S-Dutta1/AutoM8A/foosball_cam.jpg

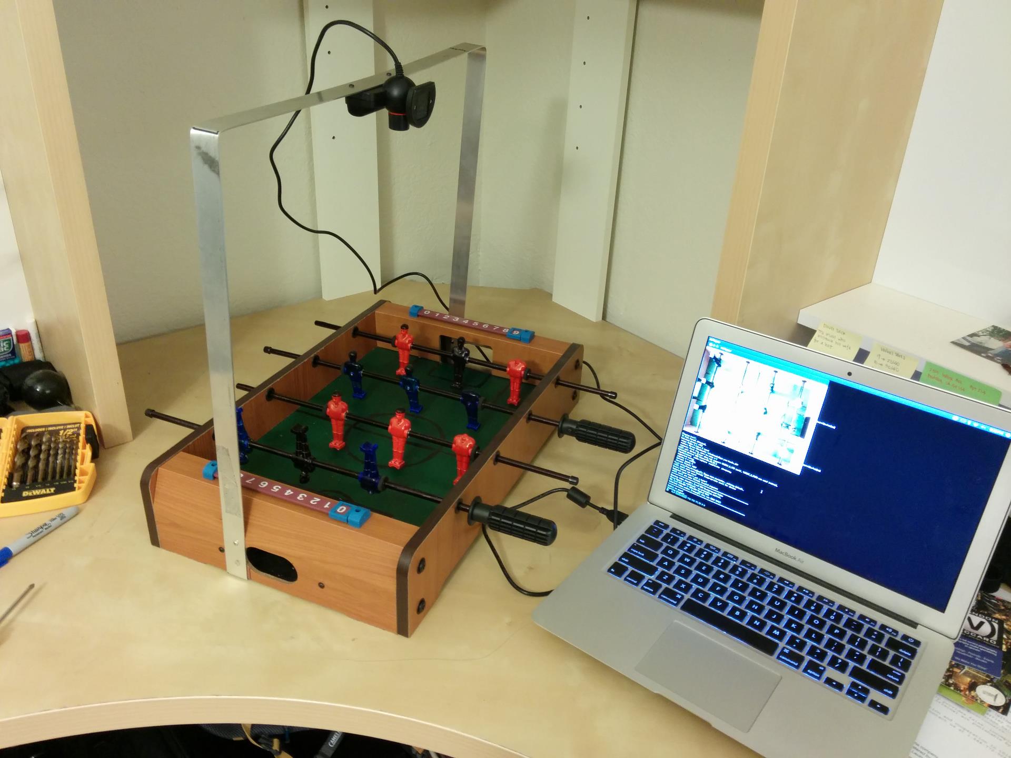
foosball_cam.jpg
