S-Dutta1/AutoM8A/README.md

# AutoM8A
ITSP (autonomous foosball table)

__Team details__ :  
1. Arkya Chatterjee  
2. Srijit Dutta  
3. Raunaque Patra   
4. Arunavo Mondal
  
*Mentor*: Abhin Shah
