S-Dutta1/AutoM8A/Billing info.ods

Component | Price | Qty | Delivery charges/tax | Total |  | Budget Expenditure
IR LED+Sensor |  |  |  | 1700 |  | 1700
LM339 comparator | 13 | 6 | 50 | 128 |  | 128
digital demux |  |  |  | 0 |  | 90
CD4067 analog mux |  |  |  | 0
V3006 servo | 400 | 4 |  | 1600 |  | 1600
Nema 17 stepper | 750 | 4 | 165 | 3165 |  | 3165
DRV8825 motor driver |  |  |  | 0 |  | 880
3D printer pulley + belt |  |  |  | 0 |  | 2250
Arduino mega |  |  |  |  |  | 700
Nuts, Bolts, wires, breadboards |  |  |  | 0 |  | 100
 |  |  | Total = | 6593 | Total = | 10613
