S-Dutta1/AutoM8A/motorControl/BasicStepperDriver.h

/*
 * Generic Stepper Motor Driver Driver
 * Indexer mode only.
 *
 * Copyright (C)2015 Laurentiu Badea
 *
 * This file may be redistributed under the terms of the MIT license.
 * A copy of this license has been included with this distribution in the file LICENSE.
 */
#ifndef STEPPER_DRIVER_BASE_H
#define STEPPER_DRIVER_BASE_H
#include <Arduino.h>
#include "BasicStepperDriver.h"

// used internally by the library to mark unconnected pins
#define PIN_UNCONNECTED -1
#define IS_CONNECTED(pin) (pin != PIN_UNCONNECTED)

/*
 * calculate the step pulse in microseconds for a given rpm value.
 * 60[s/min] * 1000000[us/s] / microsteps / steps / rpm
 */
#define STEP_PULSE(steps, microsteps, rpm) (60*1000000L/steps/microsteps/rpm)

inline void microWaitUntil(unsigned long target_micros){
    while (micros() < target_micros);
}
#define DELAY_MICROS(us) microWaitUntil(micros() + us)

/*
 * Basic Stepper Driver class.
 * Microstepping level should be externally controlled or hardwired.
 */
class BasicStepperDriver {
protected:
    int motor_steps;
    int rpm;
    int dir_pin;
    int step_pin;
    // current microstep level, must be < max_microstep
    // for 1:16 microsteps is 16
    unsigned microsteps = 1;
    // step pulse duration, depends on rpm and microstep level
    unsigned long step_pulse;

    void setDirection(int direction);
    void init(void);
    void calcStepPulse(void);

    // tWH(STEP) pulse duration, STEP high, min value (us)
    static const int step_high_min = 1;
    // tWL(STEP) pulse duration, STEP low, min value (us)
    static const int step_low_min = 1;
    // tWAKE wakeup time, nSLEEP inactive to STEP (us)
    static const int wakeup_time = 0;

public:
    // microstep range (1, 16, 32 etc)
    static const unsigned max_microstep = 128;
    /*
     * Basic connection: DIR, STEP are connected.
     */
    BasicStepperDriver(int steps, int dir_pin, int step_pin);
    /*
     * Set current microstep level, 1=full speed, 32=fine microstepping
     * Returns new level or previous level if value out of range
     */
    unsigned setMicrostep(unsigned microsteps);
    /*
     * Move the motor a given number of steps.
     * positive to move forward, negative to reverse
     */
    int move(int steps);
    /*
     * Rotate the motor a given number of degrees (1-360)
     */
    int rotate(int deg);
    /*
     * Rotate using a float or double for increased movement precision.
     */
    int rotate(double deg);
    /*
     * Set target motor RPM (1-200 is a reasonable range)
     */
    void setRPM(unsigned rpm);
};
#endif // STEPPER_DRIVER_BASE_H
