S-Dutta1/AutoM8A/(commit log)

2016-05-29 viewing angle tested
    [Billing info.ods]
2016-06-01 added latest modifications to abstract
    [Billing info.ods]
2016-06-18 added image for position of camera
2016-06-21 adding code for motor control using data from python IP code, via serial communication
2016-06-24 simple tracking algo, filter ranges updated
2016-06-26 motor control, minor mods
2016-06-28 Add files via upload
    way to send more than 8 bits to arduino
    stop bit '\n'
